roamlab/spikeatac-mini-public/CAD/README.md

# CAD Files

STL files for the 3D-printed parts and the laser cutting pattern of the SpikeATac-Mini finger. See [fabrication instructions](../fabrication_instructions.md) for print settings.

| File | Part | Material / printer |
|---|---|---|
| [`skeleton.stl`](skeleton.stl) | Finger skeleton | Grey Resin V5, Formlabs Form 4 (SLA) |
| [`mold_A.stl`](mold_A.stl) | Finger pulp mold, half A | Grey Resin V5, Formlabs Form 4 (SLA) |
| [`mold_B.stl`](mold_B.stl) | Finger pulp mold, half B | Grey Resin V5, Formlabs Form 4 (SLA) |
| [`case.stl`](case.stl) | Finger case | PLA, Bambu P1S (FDM) |
| [`stencil_A.stl`](stencil_A.stl) | Stencil A | PLA, Bambu P1S (FDM) |
| [`stencil_B.stl`](stencil_B.stl) | Stencil B | PLA, Bambu P1S (FDM) |
| [`stencil_C.stl`](stencil_C.stl) | Stencil C | PLA, Bambu P1S (FDM) |
| [`silicone_pattern.svg`](silicone_pattern.svg) | Silicone dielectric cut pattern | Laser cut from 0.005" silicone, CO2 laser |
