roamlab/spikeatac-mini-public/visualizer/finger.jpg

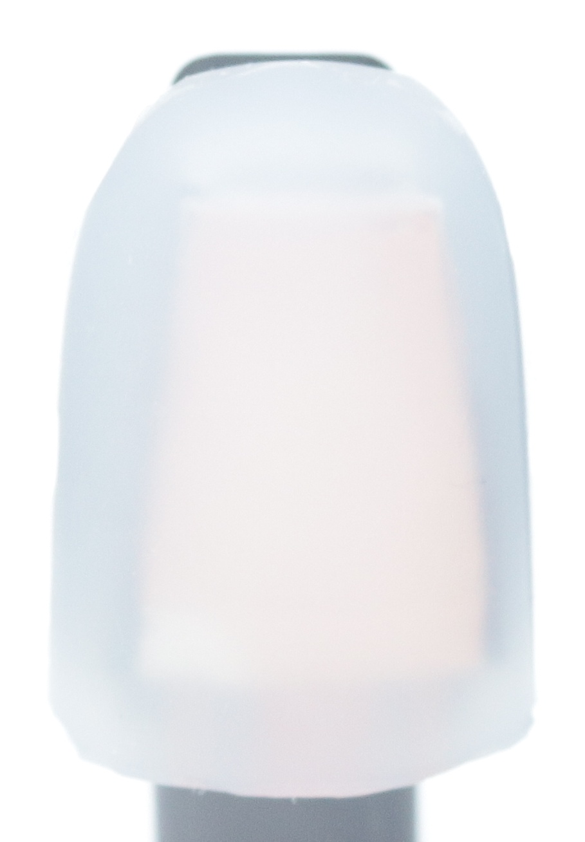
visualizer/finger.jpg
