roamlab/spikeatac-mini-public/design_files/board1/BOM_board1.xlsx

Comment | Description | Designator | Footprint | Quantity | LCSC Part #
1.5pF Embedded Planar Capacitor | 1.5pF capacitor between two layers of PCB. On a 4 layer board, place between layers 1/2 or 3/4. 1.5pF calculated for prepreg JLC04161H-1080 | C1, C2, C3, C4, C5, C6, C7, C8 | 1.5pF Embedded Planar Capacitor-Footprint-1 | 8
Capacitor 100nF +/-20% 25V 0402 | Chip Capacitor, 100nF +/-20%, 25V, 0402, Thickness 0.6 mm | C9, C10, C11, C12 | CAPC0402(1005)60_L | 4 | C1525
FH34SRJ-9S-0.5SH(50) | 9 Position FFC, FPC Connector Contacts, Top and Bottom 0.020 (0.50mm) Surface Mount, Right Angle | J1 | HRS_FH34SRJ-9S-0.5SH(50) | 1 | C3169228
Molex 513389974 (receptacle) | SlimStack Board-to-Board Receptacle, 0.40mm Pitch, J-Bend Series, 0.20µm Gold (Au) Plating, 1.50 or 2.00mm Mated Height, 3.40mm Mated Width, 12 Circuits | J2 | Molex 513389974-Footprint-1 | 1 | C588133
HVCB0603JDD1G00 | 1 GOhms Â±5% 0.06W Chip Resistor 0603 (1608 Metric) High Voltage, Moisture Resistant, Pulse Withstanding Thick Film | R1, R2, R5, R6, R9, R10, R13, R14 | RESC1607X51N | 8 | C2479785
RC0201FR-0710KL | 10 kOhms Â±1% 0.05W, 1/20W Chip Resistor 0201 (0603 Metric) Moisture Resistant Thick Film | R3, R4, R7, R8, R11, R12, R15, R16 | RESC0603X26N | 8 | C106225
LTC6242IDHCPBF | Quad 18MHz, Low Noise, Rail-to-Rail Output, CMOS Op Amp | U1, U2 | LTC6242IDHCPBF_ADI | 2 | C678743
