roamlab/spikeatac-mini-public/design_files/board2/BOM_board2.xlsx

Comment | Description | Designator | Footprint | Quantity | LCSC Part #
CL03A104KP3NNNC | 0.1 ÂµF Â±10% 10V Ceramic Capacitor X5R 0201 (0603 Metric) | C1, C2, C9 | CAPC0603X33N | 3 | C49062
CL03A105KQ3CSNH | 1 ÂµF Â±10% 6.3V Ceramic Capacitor X5R 0201 (0603 Metric) | C3, C4, C5, C6, C7, C8, C15, C16, C17 | CAPC0603X35N | 9 | C318542
GRM033R61A225KE47D | SMD capacitor X5R(EIA) with capacitance 2.2uF Tol.10%. Rated voltage 10Vdc 85C | C11, C12, C13, C14 | CAPC0603X33N | 4 | C335106
Capacitor 10µF +/-40% 6.3V 0402 | Chip Capacitor, 10µF +/-40%, 6.3V, 0402, Thickness 0.6 mm | C18 | CAPC0402(1005)60_L | 1 | C15525
Molex 5017459901 (plug) | SlimStack Board-to-Board Plug, 0.40mm Pitch, J-Bend Series, 2.00 or 2.30mm Mated Height, 3.40 or 4.20mm Mated Width, 12 Circuits | J1 | Molex 5017459901 (plug)-Footprint-1 | 1 | C724097
Molex 513389974 (receptacle) | SlimStack Board-to-Board Receptacle, 0.40mm Pitch, J-Bend Series, 0.20µm Gold (Au) Plating, 1.50 or 2.00mm Mated Height, 3.40mm Mated Width, 12 Circuits | J2 | Molex 513389974-Footprint-1 | 1 | C588133
RC0201FR-0710KL | 10 kOhms Â±1% 0.05W, 1/20W Chip Resistor 0201 (0603 Metric) Moisture Resistant Thick Film | R1, R2, R3, R4, R5, R6, R7, R8, R9, R10, R11, R12 | RESC0603X26N | 12 | C106225
ADA4691-4ACPZ-R2 | Low Power, 3.6 MHz, Low Noise, Rail-to-Rail Output, Operational Amplifiers. Equivalent to -R7 version | U1, U5 | CP_16_22_ADI | 2 | C654213
LP5907MFX-2.5/NOPB | 250-mA, low-noise, high-PSRR, ultra-low-dropout voltage regulator with low IQ and enable | U2 | SOT95P280X145-5N | 1 | C165132
XC6902N251MR-G | LDO Voltage Regulators -16V Input 3 Terminals Negative Voltage Regulator | U3 | SOT95P245X110-3N | 1 | C3748269
REF3325AIRSER | Three Terminal Voltage Reference, 1 Output, 2.5V, BIPolar, PQCC8 | U4 | FP-RSE0008A-MFG | 1 | C205952
ADS7950SBRGET | 12 bit, 1 MSPS, 4 ch, single ended, micro power, sr i/f, SAR ADC | U6 | QFN50P400X400X100-25N | 1 | C2861275
