roamlab/spikeatac-mini-public/design_files/board3/BOM.xlsx

Comment | Description | Designator | Footprint | Quantity | LCSC Part #
CL03A104KP3NNNC | 0.1 ÂµF Â±10% 10V Ceramic Capacitor X5R 0201 (0603 Metric) | C1, C2, C3 | CAPC0603X33N | 3 | C49062
BM10B-SRSS-TB(LF)(SN) | Connector Header Surface Mount 10 position 0.039" (1.00mm) | J1 | JST_BM10B-SRSS-TB(LF)(SN) | 1 | C160396
FH34SRJ-5S-0.5SH(50) | 5 Position FFC, FPC Connector Contacts, Top and Bottom 0.020 (0.50mm) Surface Mount, Right Angle | J2 | HRS_FH34SRJ-5S-0.5SH(50) | 1 | C3151177
Molex 5017459901 (plug) | SlimStack Board-to-Board Plug, 0.40mm Pitch, J-Bend Series, 2.00 or 2.30mm Mated Height, 3.40 or 4.20mm Mated Width, 12 Circuits | J3 | Molex 5017459901 (plug)-Footprint-1 | 1 | C724097
test point (exposed pad) | test point as a 1x1mm exposed pad | TP1, TP2 | testpoint | 2
AD7147ACPZ-REEL | IC CAP TO DGT 16BIT 250K 24LFCSP | U1 | CP-24-3_L | 1 | C650599
MC3479 | Accelerometers Small Digital 3-axis Accelerometer Senso | U2 | PQFN50P200X200X100-12N | 1 | C3248221
