roamlab/spikeatac-mini-public/design_files/controlboard/BOM_controlboard.xlsx

Comment | Description | Designator | Footprint | Quantity | LCSC Part #
TR3A106K016C1700 | Solid Tantalum Surface Mount Chip Capacitor, TANTAMOUNT(TM), Molded Case, Low ESR, 10 uF, +/- 10%, 16 V, -55 to 125 degC, 1206 (3216 Metric), RoHS, Tape and Reel | C1, C2 | VISH-TR3-A_V | 2 | C7171
CL05B104KO5NNNC | Ceramic Capacitor, Multilayer, Ceramic, 16V, 10% +Tol, 10% -Tol, X7R, 15% TC, 0.1uF, Surface Mount, 0402 | C3 | CAPC1050X55X23ML05T13 | 1 | C1525
CL05A105KA5NQNC | Cap Ceramic 1uF 25V X5R ±10% SMD 0402 +85°C Paper T/R | C4 | CAPC1050X55X23NL05T13 | 1 | C52923
Capacitor 1µF +/-20% 10V 0402 | Chip Capacitor, 1µF +/-20%, 10V, 0402, Thickness 0.6 mm | C5 | CAPC0402(1005)60_L | 1 | C52923
Capacitor 10µF +/-40% 6.3V 0402 | Chip Capacitor, 10µF +/-40%, 6.3V, 0402, Thickness 0.6 mm | C6 | CAPC0402(1005)60_L | 1 | C15525
Capacitor 10nF +/-20% 50V 0402 | Chip Capacitor, 10nF +/-20%, 50V, 0402, Thickness 0.6 mm | C7 | CAPC0402(1005)60_L | 1 | C15195
TLMS1100-GS08 | Red Led, 20mA, 2.1 V, -40 to 100 degC, 2-Pin SMD (0603), RoHS, Tape and Reel | DS1 | VISH-TLMX1100_V | 1 | C2286
1729128 | PCB Terminal Block, 13.5 A, 400 V, 2-Pin THD, RoHS, Bulk | J1, J2 | PHOE-1729128-2_V | 2 | DNP
BM10B-SRSS-TB(LF)(SN) | Connector Header Surface Mount 10 position 0.039" (1.00mm) | J3, J4, J5, J6 | JST_BM10B-SRSS-TB(LF)(SN) | 4 | C160396
TH Jumper | Through hole jumper to be used with 2 pin header | Jump1 | TH Jumper-Footprint-1 | 1 | DNP
DEV-16996 | Teensy 4.1 on standard female headers | MD1 | FP-DEV-16996-MFG | 1 | DNP
M2 mounting hole | Mounting hole for an M2 screw | MH1, MH2, MH3, MH4 | M2 mounting hole-Footprint-1 | 4 | DNP
100 | 100R 0.063W 1% 0402 (1005 Metric) SMD | R1, R2, R4, R5, R6, R7, R8, R9, R10, R11, R12, R13, R14, R15 | RESC0402(1005)_L | 14 | C25076
Resistor 1k +/-1% 0402 100 mW | Chip Resistor, 1 KOhm, +/- 1%, 0.1 W, -55 to 155 degC, 0402 (1005 Metric) | R3 | RESC1005X40X25ML05T05 | 1 | C11702
Resistor 10K +/-1 % 0402 63 mW | Chip Resistor, 10 kOhms, +/-1 %, 63 mW, -55 to 125 degC, 0402 | R16, R17, R18, R19, R20, R21, R22, R23, R24, R25, R26, R27 | RESC0402(1005)_L | 12 | C25744
LM1117IMPX-5.0 | 800-mA 15-V linear voltage regulator | U1 | SOT230P700X180-4N | 1 | C41202
TLV70433DBVR | 150-mA 24-V ultra-low-IQ low-dropout (LDO) voltage regulator | U2 | SOT95P280X145-5N | 1 | C94917
LT1964ES5-5#TRPBF | 200mA, Low Noise, Low Dropout Negative Micropower Regulator | U3 | SOT-5_S | 1 | C170158
