roamlab/spikeatac-mini-public/CAD/skeleton.stl

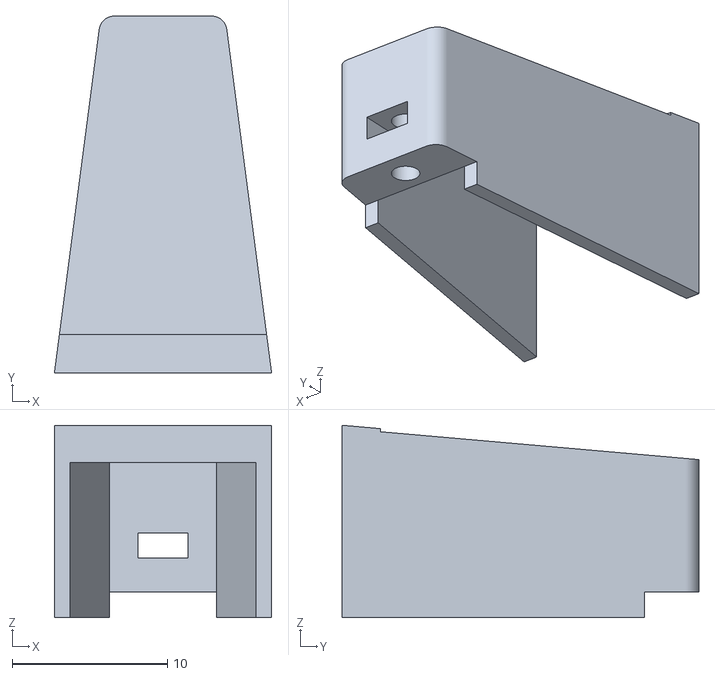
[picture p7: CAD file, 2026-11-03]
CAD/skeleton.stl
14.0 x 23.0 x 12.4
