roamlab/spikeatac-mini-public/CAD/mold_B.stl

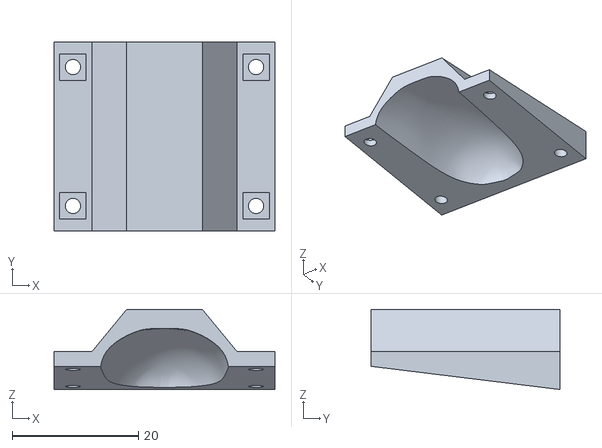
[picture p8: CAD file, 2026-11-03]
CAD/mold_B.stl
35.0 x 30.0 x 12.7
