roamlab/spikeatac-mini-public/CAD/stencil_C.stl

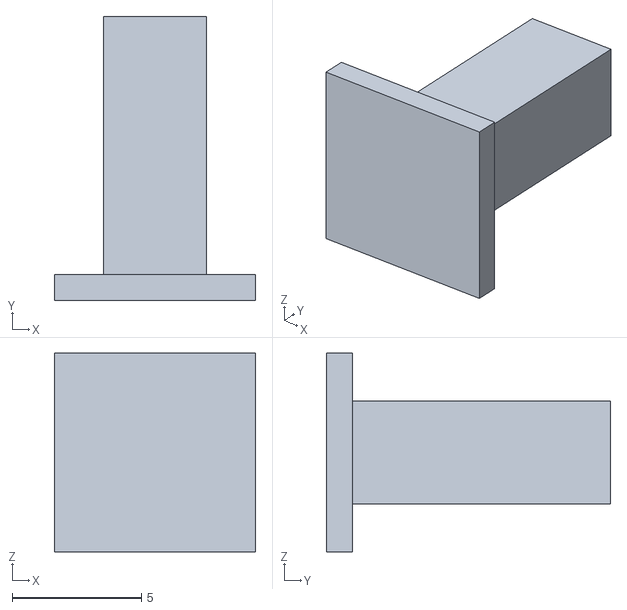
[picture p9: CAD file, 2026-11-03]
CAD/stencil_C.stl
7.80 x 11.0 x 7.70
