roamlab/spikeatac-mini-public/CAD/stencil_B.stl

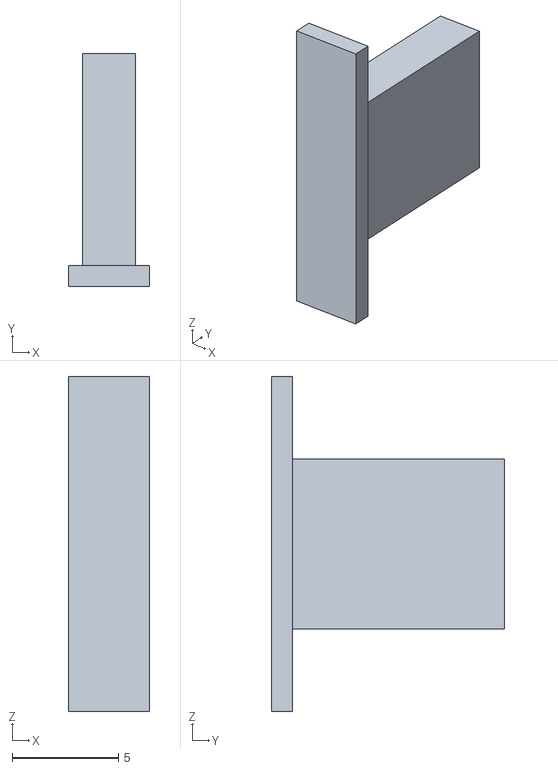
[picture p10: CAD file, 2026-11-03]
CAD/stencil_B.stl
3.80 x 11.0 x 15.8
