roamlab/spikeatac-mini-public/CAD/mold_A.stl

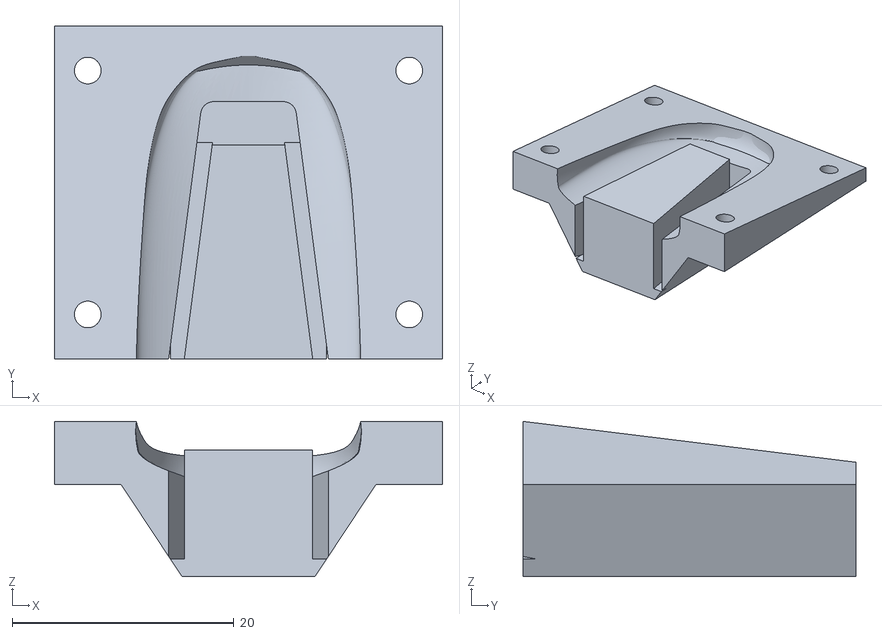
[picture p11: CAD file, 2026-11-03]
CAD/mold_A.stl
35.0 x 30.0 x 14.0
