roamlab/spikeatac-mini-public/CAD/case.stl

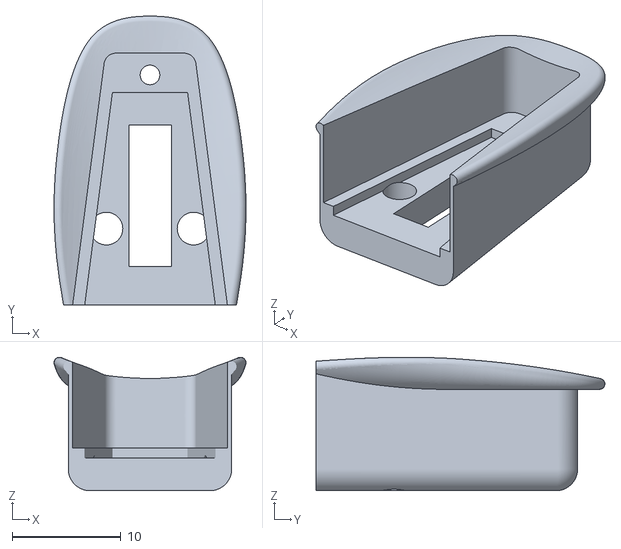
[picture p12: CAD file, 2026-11-03]
CAD/case.stl
17.6 x 26.5 x 12.2
