roamlab/spikeatac-mini-public/CAD/stencil_A.stl

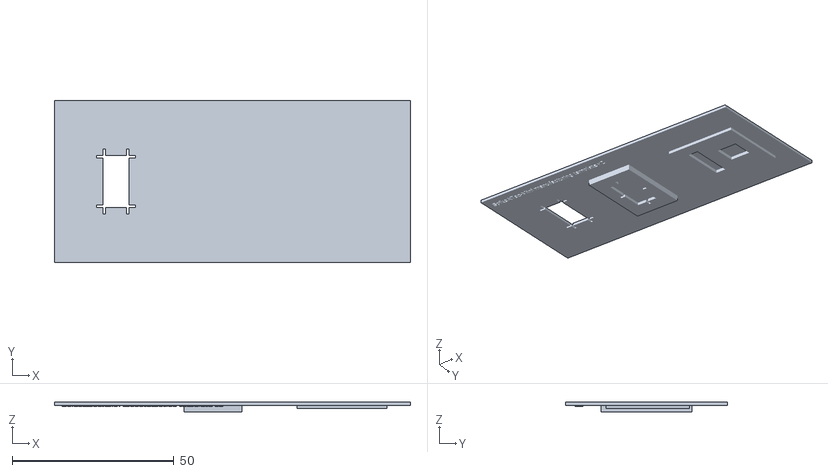
[picture p13: CAD file, 2026-11-03]
CAD/stencil_A.stl
110.0 x 50.0 x 3.00
